beleata/pravets82-fpga/README.md

# A2 / Правец 82

Нова реализация от нулата. Старите локални проекти не се използват.
Работната директория е `F:/fpga/A2`.

GitHub архив: [какво съдържа и как се възстановява](docs/github-backup.md).

## Karateka — вече стартира на физическата FPGA

В `start-a2.cmd` има бутон **Karateka**. Изчакай интрото, щракни върху
екрана, натисни **K** за клавиатура и **Enter** за начало/пропускане на интрото.
Стрелките движат героя, Space сменя бойната стойка, Q/A/Z са удари,
W/S/X — ритници. Бутонът Karateka започва отначало.
След появата на героя изчакай началната мелодия да приключи — засега тя
се изпълнява без звук и през този момент играта не реагира на движение.

Използва се конкретната еднопотребителска ProDOS версия: Windows обслужва
нейните файлови заявки през SPI. Няма Disk II контролер или ProDOS kernel;
6502 във FPGA изпълнява разопаковането и самата игра. Проверени са първата
игрова сцена, движение и зареждане на всички файлове, включително останалите
части чрез диагностичен преход. **Цялостно нормално изиграване още не е проверено.**
Няма звук; снимките на екрана забавят CPU. [Реализация и проверки](docs/karateka.md).

Външните данни са в игнорирания `build/karateka`; възстановяване:
`python tools/fetch_karateka.py`. Стартирането на прозореца изисква FPGA SRAM
дизайнът и актуалният Pico binary мост да са вече заредени.

## Жив екран и клавиатура — работи на платката

Стартирай **`start-a2.cmd`**. Щракни върху зеления екран и пиши:
клавишите стигат до 6502 във FPGA, а прозорецът показва неговата екранна RAM.
Пикото спира CPU за снимката на екранната RAM и го пуска преди USB изпращането.

- „Текст“ пуска нашата 6502 текстова програма без BASIC/Apple ROM.
- „Графика“ пуска HIRES/LORES теста с движение, рисуван от CPU във FPGA.
- Enter е нов ред, Backspace изтрива, Escape изчиства теста.
- Извън фокусирания екран клавиатурата е свободна за Windows.
- Работят 40×24 текст, две страници, inverse и flashing атрибути.
- Работят HIRES 280×192, LORES 40×48, две страници и MIXED.
- Karateka използва отделния файлов адаптер, описан по-горе; общ Disk II няма.

Проверено на физическата FPGA: 165 последователни символа с пренасяне през
редовете, Enter/Backspace, смяна на страница и въвеждане през истинския Tk
прозорец с проверка на фокуса. [Подробности и ограничения](docs/live-display.md).
Приложението изисква заредения SRAM дизайн и работещия Pico мост на COM7;
стартирането му само по себе си не програмира устройствата.

Графичен тест: A/D или стрелки движат фигурата, Space включва автоматичното
движение, 1/2 сменят страницата, H/L режима, M смесения текстов режим.
Новият USB транспорт е двоичен с CRC. Прозорецът е ограничен до 10 кадъра/s.
Графичното демо изчаква завършено рисуване: проверени са 99 цели кадъра без
разкъсване. HIRES снимката спира CPU средно за 43 ms; изпълнението се забавя.
Виж [графика и ограничения](docs/graphics.md) и [двоичен транспорт](docs/binary-transport.md).

## Текущ етап: 6502 и памет

Новото 6502 ядро изпълнява програми на платката. Налични са 48 KiB основна
RAM и 4 KiB тестова памет за вектори; зареждането и проверката стават през SPI.
Пълният независим тест на Klaus Dormann мина на физическата FPGA за 96,4 s
при 1 MHz, с успешен краен маркер. Всичките 52 KiB преминаха запис/прочит.
Виж [CPU, проверки и ограничения](docs/cpu.md) и
[команди за паметта и процесора](docs/machine-protocol.md).
Описанието на по-ранния диагностичен етап по-долу остава като история.

Това още не е завършен Apple II: екранът, клавиатурата и основните
видеопревключватели работят; Karateka стартира чрез адаптер за избраната версия.

## Цел, уточнена от Наско

Apple II / Правец 82 съвместим компютър във FPGA. Windows приложението
показва неговия екран, прихваща клавиатурата само при фокус и предоставя
виртуални дискети. Pico #2 свързва Windows и FPGA през USB и SPI.
Първият критерий за използваемост е зареждане на програма/игра от
виртуална дискета и управление през Windows. BASIC не е отделна цел
или задължителен междинен етап.

**Първа избрана игра: оригиналната Karateka за Apple II (1984).**
Подробности и непроверени зависимости: `docs/karateka.md`.

ROM частите могат да се пропускат само след проверка на зависимостите
на избрания софтуер. Програма на машинен код също може да извиква ROM.
Ще има профил за съвместимост с нужния ROM и по възможност минимален
профил за самостоятелно зареждащ се софтуер. Не обещаваме спестени 12 KiB
или универсална съвместимост преди реално тестване.

## Какво има сега

- `rtl/a2_spi_diagnostic.v`: нов синхронен SPI mode 0 модул.
- `pico/bridge.py`: нов MicroPython USB↔SPI диагностичен мост.
- `pico/pio_spi.py`: ускорен SPI master с PIO и DMA.
- `host/diagnose.py`: Windows/Python диагностичен клиент.
- `host/pico_repl.py`: изпълнение на Pico кода в RAM без запис във флаша.
- `tools/build_fpga.py`, `tools/program_fpga.py`: нови build/program команди.
- `tests/run_rtl.py`: симулация на действителния Verilog чрез Yosys CXXRTL.
- `tests/test_bridge.py`: проверки на валидирането на USB заявките.
- `docs/hardware.md`: единственото потвърдено окабеляване.
- `docs/protocol.md`: новият диагностичен протокол.

Това е началният транспортен слой. CPU, Apple памет, Disk II, екранният
протокол и Windows графичният прозорец още не са реализирани.
**Вече проверено на физическата платка:** новият FPGA bitstream е в SRAM,
Pico мостът работи на COM7 с PIO SPI на 2 MHz. Идентификаторът A2,
проверочният шаблон, неизвестните команди, живият брояч и echo минават.
Записът по JTAG отчете readback mismatch; отделният SPI тест доказа
работещия нов дизайн, но причината за JTAG несъответствието не е решена.
Конфигурационният флаш не е записван. Всичко се изпълнява от RAM.
Подробни измервания и възстановяване: `docs/bring-up.md`.

## Локална проверка

От тази директория:

```powershell
python -m pytest tests/test_bridge.py -q
python tests/run_rtl.py --yosys F:/fpga/AgRV_pio/AgRV_pio/packages/tool-agrv_logic/map/bin/yosys.exe
```

Yosys е инструмент от SDK, а не зависимост от стария проект.
Нужен е и `g++` (наличен на тази машина). Първото изпълнение изтегля
двата официални CXXRTL runtime headers от Yosys v0.52 в `build/`;
това са файлове на симулатора, а не чужда реализация на SPI.
Генерираните стимули и логовете са в `build/simulation/`.
`--interpreted` използва вградения симулатор без C++ компилатор, но е
значително по-бавен. `tests/assertion_probe.v` е умишлено провалящ се
контролен тест за неговите assertions, не част от FPGA дизайна.

Потвърдени софтуерни проверки на 2026-09-26: 17 Python теста и
51 завършени SPI транзакции в RTL симулация, включително всички 256
байтови стойности в echo, три тактови интервала, частични команди,
прекъснат отговор, reset и паузи. Симулацията проверява 167804 clk
цикъла и има отрицателна контрола с умишлено сгрешен очакван бит.

Когато новият FPGA дизайн е зареден и Pico мостът работи:

```powershell
python host/diagnose.py --port COM7
```

COM7 е потвърден в тази сесия; номерът може да се промени при включване
в друг USB порт. PIO мостът може да се стартира така:

```powershell
python host/pico_repl.py --port COM7 --start-bridge --backend pio --spi-hz 2000000
```

## Дискети и следващи етапи

1. Проверка на транспорта, хардуерните параметри и реалния паметен бюджет.
2. 6502, Apple адресиране и тестова програма за екран и клавиатура.
3. Disk II поведение и boot, с read-only образ на обикновена дискета.
4. Реална програма/игра, графика, звук и съвместимост според изискванията ѝ.
5. Запис на дискети и по-сложни дискови формати/защити.

Windows пази файловете с образите. Disk II логиката във FPGA вижда
локално буферирани данни; четене на отделен дисков бит не чака USB.
Местоположението и размерът на буфера (FPGA/Pico) се избират след измерен
SPI throughput и паметен бюджет. Недостигът на данни и смяната на писта
изискват изрично поведение; не бива да връщаме случайни или стари данни.

За начало: стандартни 35-пистови, 16-секторни образи `.dsk`/`.do`,
143360 байта. Файлът съдържа сектори, а контролерът очаква дисков поток:
нужно е кодиране на адресните и данните полета, gaps и проверки.
Редът на секторите трябва да е изричен, а не да се гадае само по `.dsk`.
За защитени оригинални игри може да е нужен `.woz` с по-точна времева
информация; този формат не е обещан в първата версия.

Технически референции (не старият локален код):
- https://github.com/AppleWin/AppleWin
- https://www.cs.columbia.edu/~sedwards/apple2fpga/
