beleata/pravets82-fpga/docs/hardware.md

# Проверено окабеляване

| SPI сигнал | FPGA извод | Pico #2 GPIO | Pico физически пин |
|---|---|---|---|
| SCK | 38 | GP20 | 26 |
| MOSI | 42 | GP19 | 25 |
| MISO | 39 | GP21 | 27 |
| CS | 44 | GP18 | 24 |
| IRQ | 43 | GP16 | 21 |

Обща маса през P2.2. CS е активно нисък в новия протокол.
Pico #1 е отделният JTAG програматор: GP11→J2.1 TCK,
GP12→J2.5 TMS, GP15→J2.9 TDI, GP16→J2.3 TDO, GND→J2.2.

Предишните програми и конфигурации не са източник на истина за тази
реализация. Тестовият RTL приема външни clk и reset.

## Допълнително проверено на 2026-09-26

- Пряко JTAG четене: IDCODE `0x01000011`. Windows вижда Altera USB-Blaster,
  VID:PID 09FB:6001, Altera драйвер 2.12.28.0.
- COM7: MicroPython 1.29.0, Raspberry Pi Pico с RP2040, USB serial
  E66058388326A925. Идентификацията е прочетена през новия raw-REPL loader.
- По схемата `F:/fpga/agm-tcx/AGM-TCX_AG10KL144H_schematic.pdf`, стр. 1:
  50 MHz осцилаторът Q подава CLK към PIN_23; всички VCCIO са към 3.3V.
  Това е проверка по схемата, не ново измерване с мултиметър.
- LED на PIN_141 е активно нисък. Новият wrapper го използва за heartbeat.
- Бутонът в тази схема е вързан към IO38, който използваме за SCK.
  Няма външен reset бутон в новия дизайн; не натискай този бутон по време
  на SPI тест. Startup reset се генерира вътре в FPGA.
- Native инструментът с DEVICE=AG10KL144H отчита 56 блокови RAM ресурса.
  Другите общи resource totals в отчета не се приемат автоматично за
  физическа спецификация на корпуса. Полезният RAM бюджет за Apple II
  остава за отделна проверка с реална организация на паметта.

Всички седем използвани извода и 3.3-V LVTTL настройките са проверени
и в получения `build/fpga/alta_db/io.asf` преди програмиране.
