beleata/pravets82-fpga/docs/protocol.md

# A2 диагностичен протокол, версия 1

Този протокол е нов и не следва стария проект.
SPI mode 0, MSB first, CS нисък за цялата транзакция.
Първият приет байт е opcode; полученият едновременно байт е 00.
Отговорът започва от следващия байт, без допълнителен dummy бит.
MOSI се приема на нарастващ SCK, MISO се сменя на спадащ SCK.

| Opcode | Следващи изходни байтове от FPGA |
|---|---|
| 00 | 41 32 01 00: ASCII A2, major 1, minor 0 |
| 10 | A5 C3 3C 5A: проверка на битовия ред |
| 20 | 32-битов брояч на clk, snapshot при приемане на opcode |
| 30 | 00, после всеки получен payload байт с един байт закъснение |
| друго | BA D0 C0 DE |

За фиксиран отговор master праща opcode + четири нулеви байта.
След четирите байта отговор се връщат нули до вдигането на CS.
Echo: TX `30 12 34 56 00` → RX `00 00 12 34 56`.
Нова команда изисква нов импулс на CS. Вдигането му отменя и частичен байт.
IRQ е резервиран и остава нисък в тази диагностична версия.

RTL синхронизира SCK, CS и MOSI към clk. Всяко високо и ниско ниво на
SCK, както и CS setup/hold и паузата между транзакции, трябва да трае
поне 8 периода на clk. MOSI се сменя със спадащия SCK или по-рано в
ниската фаза. Това е условие на интерфейса; максимална физическа скорост
ще се обяви след timing проверка и измерване на платката.

USB мостът използва ограничени по дължина JSON редове за диагностиката:
`{"id":1,"tx":"1000000000"}` → `{"id":1,"rx":"00a5c33c5a","irq":0}`.
До 8194 SPI байта на заявка, до 16516 символа в USB ред. Некоректна заявка
връща error без SPI транзакция. Пълният екранен транспорт е следващ етап.

8194 байта позволяват echo тест с 8 KiB полезни данни плюс opcode и
заключителен dummy байт. В `pico/pio_spi.py` PIO0 SM0 генерира SCK и
MOSI, а две DMA линии пренасят байтовете в двете посоки. Валидирани са
100 kHz, 500 kHz, 1 MHz и 2 MHz; използваният работен режим е 2 MHz.
Това е диагностичен JSON транспорт, не окончателният видео/дисков протокол.
