beleata/pravets82-fpga/docs/graphics.md

# Графика на физическата FPGA

Работят HIRES 280×192 (страници `$2000` и `$4000`), LORES 40×48 в
16 цвята, TEXT 40×24 и MIXED с четири текстови реда отдолу. Използват се
вече реализираните Apple II soft switches, без нов FPGA bitstream за този етап.
Windows интерпретира реалната RAM; CPU и програмата остават във FPGA.

В прозореца „Графика“ зарежда нашата самостоятелна 6502 програма. Тя сама
изчиства двете страници, рисува цветните полета, записва текста и движи бялата
фигура. Данните не са локална Windows анимация. „Текст“ връща текстовия тест.

Контроли в графичния тест:

| Клавиш | Действие |
|---|---|
| A/D или лява/дясна стрелка | Ръчно движение; спира автоматичното |
| Space | Включва/изключва автоматичното движение |
| 1 / 2 | Екранна страница |
| H / L | HIRES / LORES |
| M | MIXED / цял графичен екран |
| Escape | Рестартира демонстрацията |

„Цвят“ превключва цветно/монохромно HIRES визуализиране в Windows.
Превключвателят не променя паметта или програмата на FPGA.

## Адресиране и визуализация

HIRES редът е `base + (y&7)*1024 + ((y>>3)&7)*128 + (y>>6)*40`.
Всеки байт дава седем точки, най-младшият бит е вляво. Bit 7 забавя
съответната група с половин точка и сменя цветовата група. Рендерът използва
560 хоризонтални позиции за това отместване, после мащабира до 640×480.
512-те неизползвани байта между видимите редове не се рисуват.

Цветното HIRES е практическо RGB приближение: единични точки дават
виолетово/зелено или синьо/оранжево, съседни светли точки — бяло, а повтарящ
се редуващ се шаблон се запълва като плътен цвят. Това не е пълен NTSC
декодер; сложни гранични и dithering ефекти могат да се различават от телевизор.
LORES използва младшата тетрада за горния блок и старшата за долния.

Справки: [Apple II Reference Manual, 1978](https://apple2history.org/dl/Apple_II_Redbook.pdf)
и [описанието на Wozniak за HIRES](https://mirrors.apple2.org.za/Apple%20II%20Documentation%20Project/Computers/Apple%20II/Apple%20II/Manuals/Steve%20Wozniak%20-%20High%20Resolution%20Color%20Graphics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).

## Измерено и проверено

- Пълна проверка на 52 KiB RAM и краткия CPU тест през новия транспорт.
- На физическата FPGA: двете графични страници, HIRES/LORES/MIXED,
  клавиатурно движение и 24 различни снимки на движещата се фигура.
- Компактно четене: 24×8192 байта за 1,196 s, около **164 KB/s / 20 HIRES
  страници/s**. Това е транспортът, не FPS на приложението.
- Цялото приложение вече е ограничено до **10 кадъра/s**, измерени около 9–10.
  Статусът показва текущата честота и продължителността на CPU паузата.
- UI проверката подава Windows/Tk кодове с Num Lock (`state=8`), превключва
  режимите през 6502 и проверява реалните кадри, включително целостта на всички
  12 реда на фигурката. Последната снимка е направена при включено движение.

Отчети: `build/hardware/graphics.json`, `graphics-window.json`,
`binary-soak.json`. Тестове: `test_graphics.py`, `test_binary_bridge.py`,
`host/test_graphics.py` и `tests/test_graphics_app_live.py`.

## Синхронизирани снимки

USB заявката `A2S!` се изпълнява изцяло на Pico: пауза на CPU, прочит на
регистри и избраната текстова/графична страница, възстановяване на CPU,
после изпращане по USB. Копира се само екранната памет (1 KiB или 9 KiB),
не цялата 48 KiB RAM. Windows публикува получената снимка като един кадър.
Ръчно спрян CPU остава спрян. Не се променя FPGA bitstream.

Самата пауза може да улучи програма по средата на рисуване. Затова нашето
демо поставя `$0300=1` само в изчакването след завършен кадър, а преди
промени го изчиства. Pico проверява този байт преди И след паузата; при
състезание пуска CPU и опитва пак. След 150 ms без готов кадър пропуска
снимката и Windows запазва предишната. При свързване GUI включва тази
проверка само ако PC е в демонстрацията и кодът в `$1000` съвпада изцяло.

Физическа проверка `python host/test_snapshot.py`: 99 кадъра за 10,13 s,
36 различни положения, нула частични фигурки, един пропуск при стартиране.
Средна пауза 43,4 ms, максимална 50,4 ms; CPU е спрян 42,4% от времето.
Това е временен компромис, който забавя програмата. Потребителската пауза,
възобновяването и неизменността на програмния код също са проверени.
Отчет: `build/hardware/snapshot.json`.

За произволни Apple II програми остава атомичната RAM снимка, без обещание,
че е завършен игрови кадър. Те не познават нашия `$0300` маркер; ще е нужна
отделна стратегия за съгласуване, без подмяна на игровия код. Няма още
Disk II, звук или floating bus. Karateka вече се зарежда чрез отделния
файлов адаптер, описан в `karateka.md`.
