beleata/pravets82-fpga/docs/karateka.md

# Първа цел: Karateka, Apple II, 1984

Наско избра оригиналната Apple II версия, посочвайки walkthrough на
играта. Това е избор на софтуер за нашия FPGA компютър, не заявка за
възпроизвеждане на видеоклип или за Windows емулация на 6502.

## Критерий за успех

1. Стартираме избраната версия от бутона Karateka в Windows приложението.
2. Машината във FPGA зарежда играта през специализирания SPI файлов адаптер.
3. Началните екрани и игровата графика се показват в Windows през SPI/USB.
4. Наско може да управлява героя с клавиатурата на активния прозорец.
5. Проверяваме преходите и дозарежданията през цялата игра; един screenshot
   от заглавния екран не доказва работеща игра.

## Работни решения

- Уточнение от Наско: първо проверяваме директно зареждане в RAM през SPI,
  вместо да реализираме Disk II предварително. Самото записване на RAM и
  стартиране по reset vector вече работи за нашите програми. Няма започната
  реализация на дисков контролер; тази работа е отложена.
- Директен старт изисква разположен изпълним образ и начално състояние,
  не просто копиране на `.dsk` файла. Проверяваме ROM зависимостите и
  последващите зареждания. За избрано заглавие е възможна адаптация на
  зареждащата рутина към SPI услуга, но това е профил за конкретна игра,
  а не обща Disk II съвместимост. Реализираният вариант е описан по-долу.
- Има първично наблюдение за дозареждане в оригинална WOZ версия на
  Karateka, включително след сцена в последното ниво:
  https://mametesters.org/view.php?id=7974 (описание от тестера, ред Steps To Reproduce).
  Следователно една начална 48 KiB снимка не е доказателство, че цялата
  игра ще работи без допълнителни данни. Нашият адаптер обслужва и дозарежданията.
- BASIC prompt не е критерий. Не добавяме BASIC заради самия BASIC.
- ROM зависимостите се проверяват върху конкретния образ; не приемаме,
  че игра на машинен код непременно е независима от системния ROM.
- Двете hi-res страници, изборът на активна страница и цветовото
  изобразяване трябва да са част от реализацията, не само текстов терминал.
- Предвиждаме преобразуване на Windows клавиши към Apple клавиатура
  и/или виртуален джойстик според реалното управление на избраната версия.
  При загуба на фокус освобождаваме всички задържани контроли.
- Скоростта на играта трябва да е близка до оригиналната Apple II;
  по-бърз SPI не означава ускорен CPU.
- Запис на дискетата не е нужен за първия boot/play тест.

## Какво е известно и какво остава да се установи

Авторът потвърждава Apple II произхода и годината. В собствения си архив
описва разработването на играта на 48K Apple II. Това е добра отправна
точка за 48 KiB RAM, но не доказва изискванията на всеки разпространен
образ, loader или модификация.

Избраният образ е описан по-долу с произход, размер и SHA-256.
Не приемаме, че секторен `.dsk` възпроизвежда защитата на оригиналната
физическа дискета. Образ с оригиналния битов поток може да изисква
различна реализация от стандартните секторни образи.

## Първични източници

- Авторът за играта: https://www.jordanmechner.com/en/games-movies/karateka/
- Архивът на автора, разказът за 48K Apple II:
  https://mail.jordanmechner.com/en/archive/
- Първичен анализ от автора на двуиграчен patch: оригиналните клавиатурни
  входове и достъпите до $C000/$C010, изборът на клавиатура с K:
  https://retroconnector.com/karateka-two-player/

Този анализ потвърждава, че клавиатурното управление е приложима посока;
не планираме да използваме двуиграчната модификация като избраната игра.

## Реализирано на 2026-09-26

Наско уточни, че го интересува само Karateka и разреши адаптация за нея.
Използваме еднопотребителската ProDOS адаптация от архива на Total Replay,
`res/dsk/karateka PRODOS (san inc pack).po`, 143360 байта, SHA-256
`12c7990fb427f464d8ba9aa366514f505127d63d2351949318d201dae72e3efe`.
Това е адаптирана Apple II версия на оригиналната игра, не немодифициран
защитен образ на физическата дискета и не двуиграчният patch.

`tools/fetch_karateka.py` проверява хешовете преди употреба и записва произхода
в `build/karateka/runtime-sources.json`. Всички външни ROM/игрови данни са
само в игнорирания build каталог. Първоначално проучената 48 KiB снимка от
RHDL и DOS образът НЕ се използват от крайния runtime. Кодът на старите
локални FPGA проекти също не се използва.

### Зареждане без Disk II

`host/karateka.py` извлича седемте файла от проверения ProDOS образ:
`KARATEKA`, `.1` до `.5`, `.A`. Първият влиза в `$3FF6` и оригиналният
6502 unpacker се изпълнява във FPGA. Няма софтуерна CPU емулация в приложението.

На `$BF00` поставяме JMP към нашия малък 6502 адаптер в `$F100`.
Той разбира стандартния формат на MLI повикването, запазва X/Y и използвания
временно zero-page указател, премества адреса за връщане след параметрите,
публикува заявка в `$F180..F183` и чака. Windows спира CPU, изпълнява
конкретната операция, записва резултата в RAM, потвърждава последен и пуска CPU.
Не се записва flash. Оригиналният loader сам запазва/възстановява страницата
`$BF00`; JMP към нашия адаптер се запазва през тези операции.

Поддържат се само използваните от тази версия GET_PREFIX `$C7`, OPEN `$C8`,
READ `$CA`, CLOSE `$CC`. Позволени са само имената на седемте вградени файла,
без запис. Отвореният файл и позицията се пазят в `$F1A0..F1B3`, така че
повторното свързване на Windows не ги губи. Подписът е в `$F1C0`.
Грешка оставя CPU спрян и заявката непотвърдена. Ръчната пауза се запазва.

Горната банка съдържа последните 4 KiB от проверения Apple ROM, като
`$F000` е стартов код, `$F100..F1FF` са адаптер и служебни данни.
Това не е пълен Apple ROM профил; `$D000..EFFF` не са добавяни. CPU и
основната RAM са същите. Единствената RTL промяна връща нула за липсващите
входове `$C060..C063`: предишното `$FF` лъжливо означаваше натиснати бутони.
Не са добавяни BRAM блокове: 2058 LUT, 446 FF, 52 BRAM;
final setup +5.607 ns, hold +0.292 ns, нула build грешки/предупреждения.
Познатото JTAG readback несъответствие остава отчетено; новият дизайн е
проверен отделно чрез SPI, включително четене на новите нулеви входове.

### Физически проверки

- Играта зареди `.1`, прие K/начало и зареди `.A` и `.2` през SPI.
  Първата игрова сцена и анимацията се изпълняват на FPGA.
- Осем клавиша надясно промениха позиционните байтове `$50..53` от
  `01fe3000` на `05fa2cf6`.
- Диагностични скокове към оригиналната игрова рутина за зареждане провериха
  `.3`, `.4`, `.5`, разопаковането и маркерите `$BFFD..BFFF` за съответната част.
  Това НЕ е изиграване на естествените преходи между нивата.
- Tk приложението зареди играта, получи 589 кадъра за около 66 s, около
  9 кадъра/s, без CPU halt; RAM потвърди първото ниво и клавиатурния режим.
  Изолирано подаване към клавиатурния обработчик промени позицията от
  `01fe3000` на `021d1ffa`. Прозорецът е скрит в теста, за да не отнема
  фокуса от потребителя; това не е проверка на физически Windows натискания.
  Първите кратки проверки стигаха до началната музикална рутина; удълженият
  тест изчаква края ѝ преди стрелките. Артефактът е собственото Tk изображение,
  не screenshot на работния плот, който може да е покрит от друг прозорец.
- 40 локални проверки и интегрираните RTL SPI/CPU/RAM тестове минаха.

Отчети: `build/hardware/karateka-first.json`, `karateka-levels.json`,
`karateka-app-frame.json`. Кадрите са прочетени от физическата FPGA RAM.
`tools/probe_karateka.py` е отделен анализ с py65 в `build/analysisdeps`,
използван за проучване на файловите заявки. Не участва в runtime и неговите
резултати не се представят като хардуерни проверки.

### Оставащи ограничения

Цяла нормална игра до спасяването на Марико още не е проверена. Няма звук,
джойстик или обща ProDOS/Disk II съвместимост. Клавиатурата се избира с K.
Показването е до 10 кадъра/s и паузите за снимки забавят реалния CPU.
Karateka сменя двете графични страници сама; използваме атомична RAM снимка,
без маркера `$0300` на нашето демо, защото играта използва тази памет.
ROM зависимости в непроверените игрови ситуации остават възможни.
При първата сцена оригиналната музикална рутина временно задържа играта,
макар да няма звуков изход. След нейния край героят се управлява нормално;
допълнителното забавяне от екранните снимки удължава този тих начален момент.
