beleata/pravets82-fpga/docs/checkpoint/karateka-app-frame.png

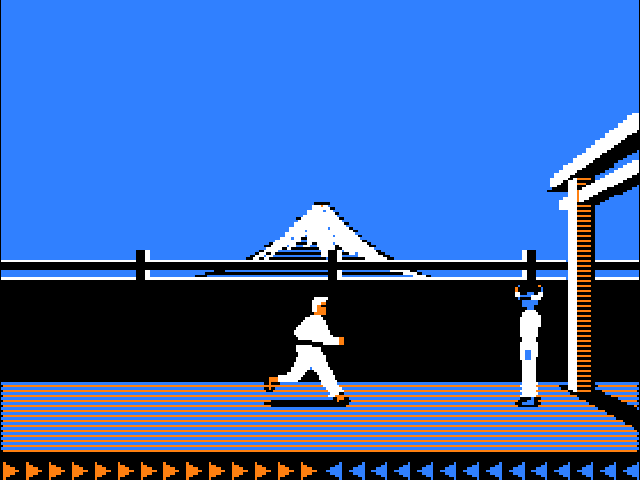
docs/checkpoint/karateka-app-frame.png
